gurinder-raju/workbench/README.md

# workbench

Build and make projects — CAD models, prototypes, and iteration notes.

| Project | Description |
|---|---|
| [watch-case](watch-case/) | Pebble-shaped watch case with a hidden 12-to-6 strap tunnel (STL prototypes; V8 adds parametric CAD and STEP; V9 adds water-resistance seals) |
