gurinder-raju/workbench/watch-case/GH_watch_case_V9_pebble42/GH_watch_case_V9_pebble42_assembly_preview.stl

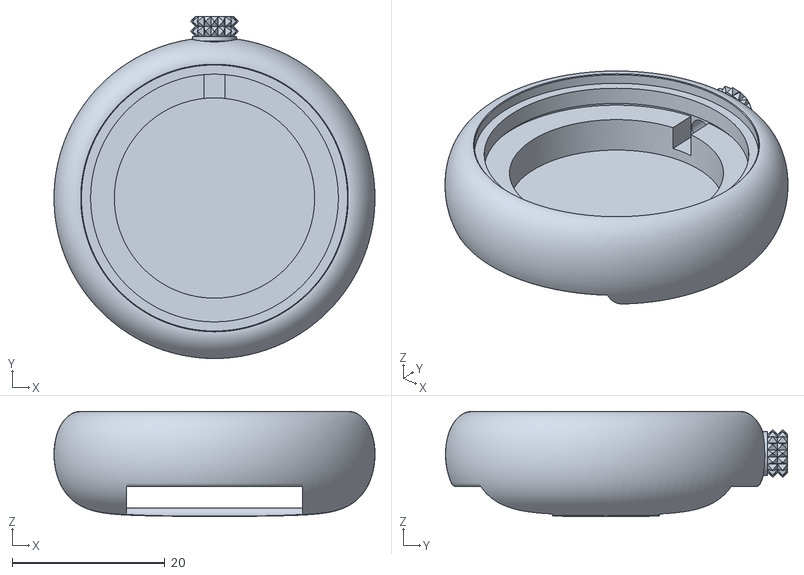
[picture p2: CAD file, 2026-10-15]
watch-case/GH_watch_case_V9_pebble42/GH_watch_case_V9_pebble42_assembly_preview.stl
42.0 x 44.7 x 13.8
