gurinder-raju/workbench/watch-case/step/GH_watch_case_V9_pebble42_assembly.step

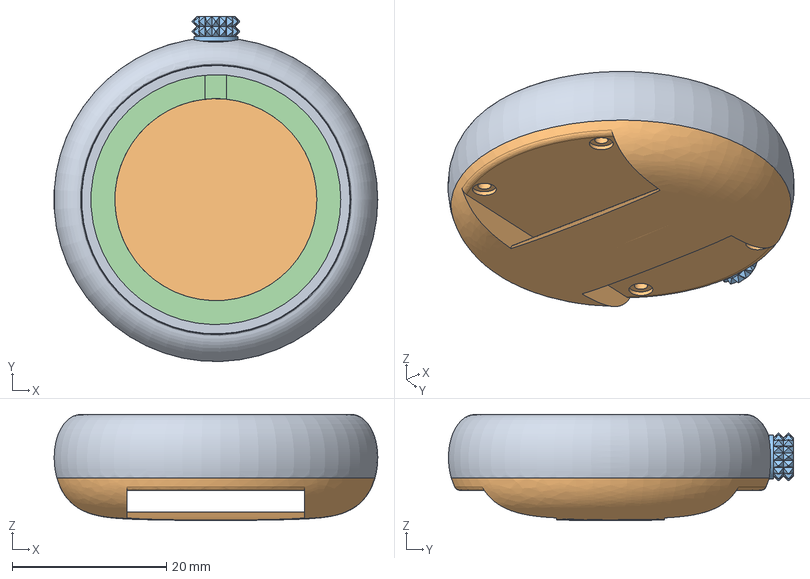
[picture p3: CAD file, 2026-10-15]
watch-case/step/GH_watch_case_V9_pebble42_assembly.step
42.0 x 44.7 x 13.8 mm
