gurinder-raju/workbench/watch-case/GH_watch_case_V7_symmetric_pebble_roundover.stl

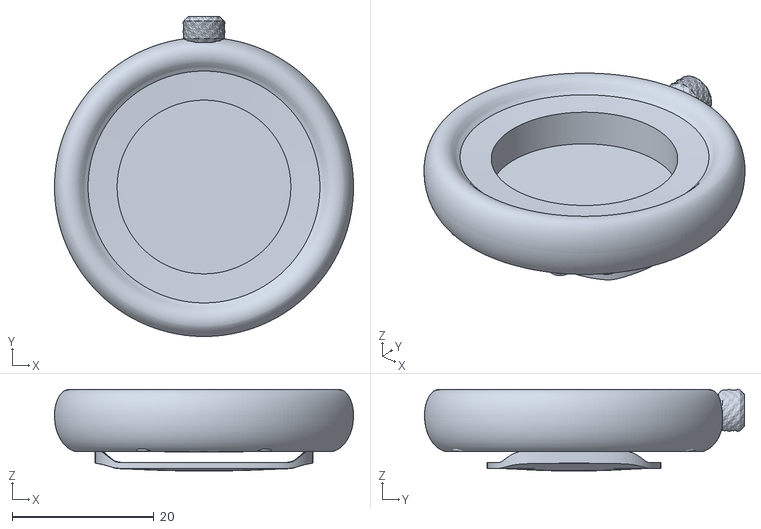
[picture p4: CAD file, 2026-10-13]
watch-case/GH_watch_case_V7_symmetric_pebble_roundover.stl
42.2 x 45.1 x 11.5
