gurinder-raju/workbench/watch-case/GH_watch_case_V9_pebble42/GH_watch_case_V9_pebble42_caseback_bridge.stl

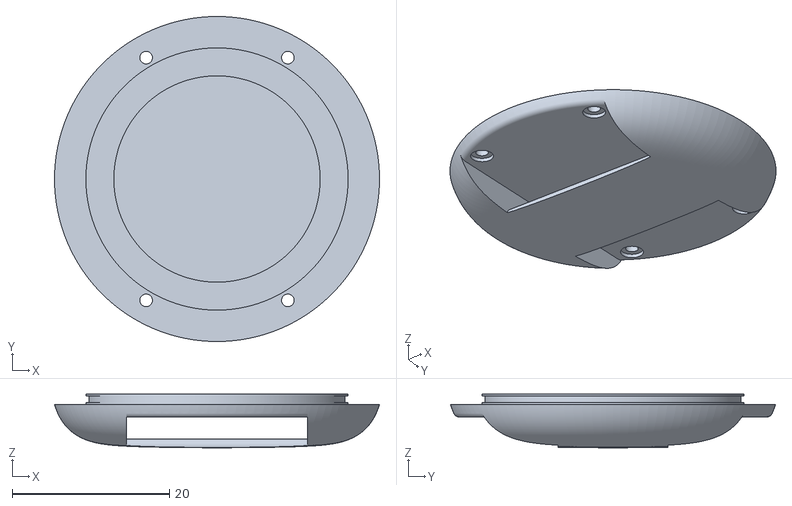
[picture p5: CAD file, 2026-10-15]
watch-case/GH_watch_case_V9_pebble42/GH_watch_case_V9_pebble42_caseback_bridge.stl
41.3 x 41.3 x 6.80
