gurinder-raju/workbench/watch-case/step/GH_watch_case_V9_pebble42_crown.step

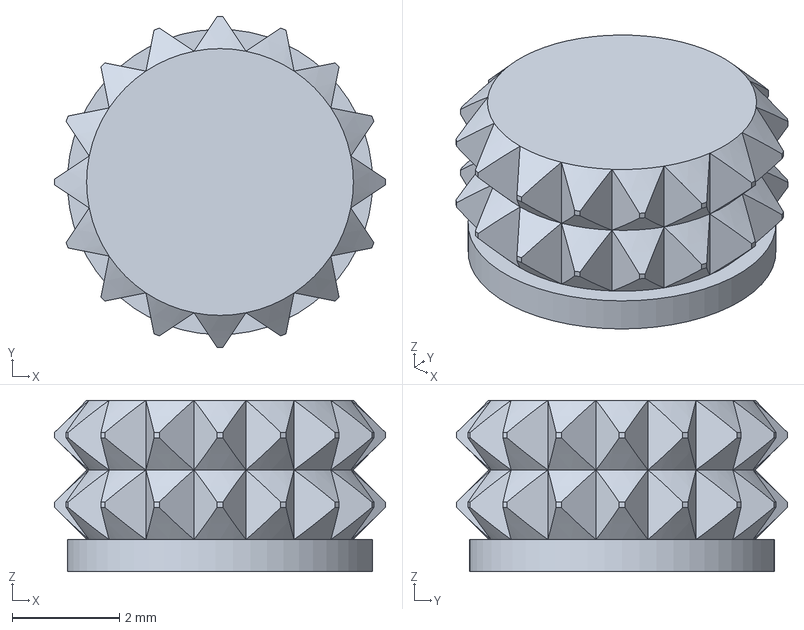
[picture p6: CAD file, 2026-10-15]
watch-case/step/GH_watch_case_V9_pebble42_crown.step
6.18 x 6.18 x 3.20 mm
