gurinder-raju/workbench/watch-case/GH_watch_case_V4_enclosed_pebble_case.stl

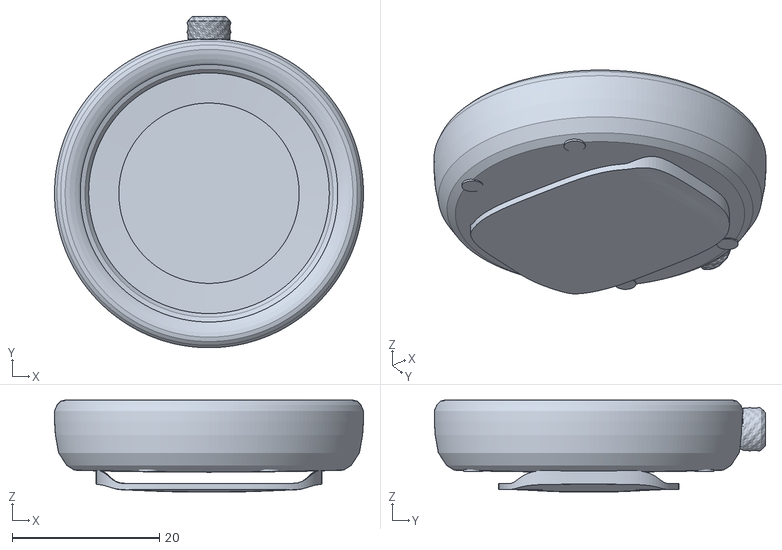
[picture p7: CAD file, 2026-10-13]
watch-case/GH_watch_case_V4_enclosed_pebble_case.stl
42.0 x 45.0 x 12.5
