gurinder-raju/workbench/watch-case/step/GH_watch_case_V9_pebble42_movement_ring.step

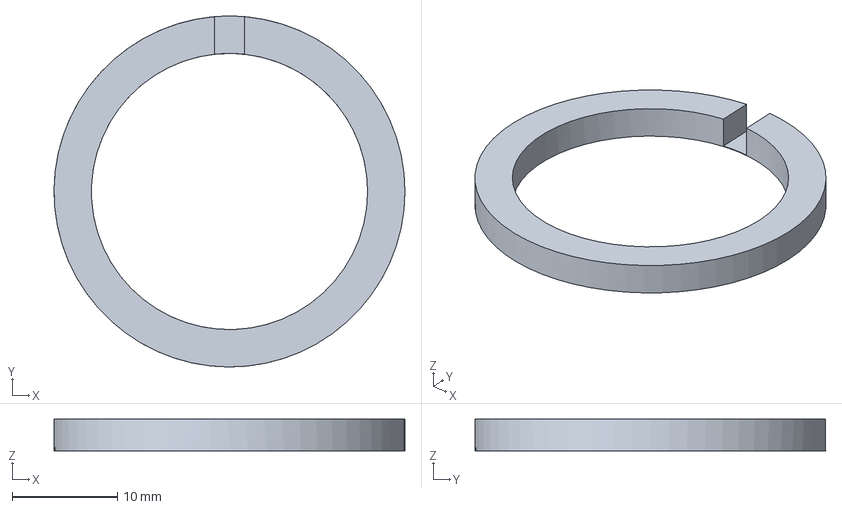
[picture p8: CAD file, 2026-10-15]
watch-case/step/GH_watch_case_V9_pebble42_movement_ring.step
33.3 x 33.3 x 3.00 mm
