gurinder-raju/workbench/watch-case/GH_watch_case_V3_comfort_back_hidden_tunnel.stl

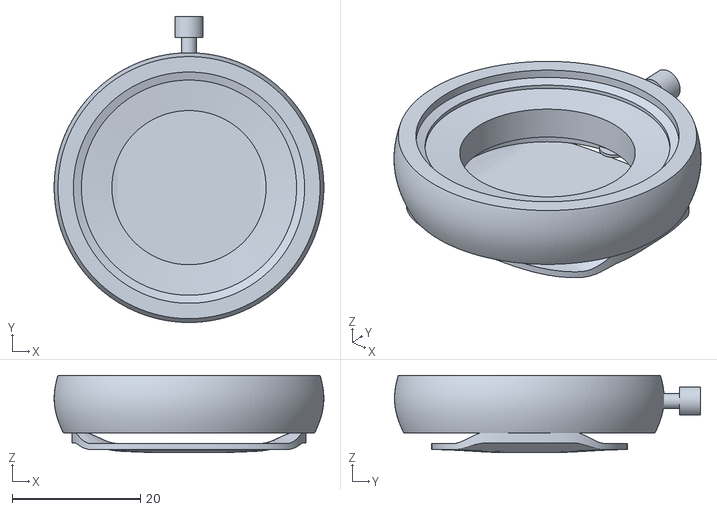
[picture p9: CAD file, 2026-10-11]
watch-case/GH_watch_case_V3_comfort_back_hidden_tunnel.stl
42.0 x 47.7 x 12.1
