gurinder-raju/workbench/watch-case/GH_watch_case_V1_attached_hidden_tunnel.stl

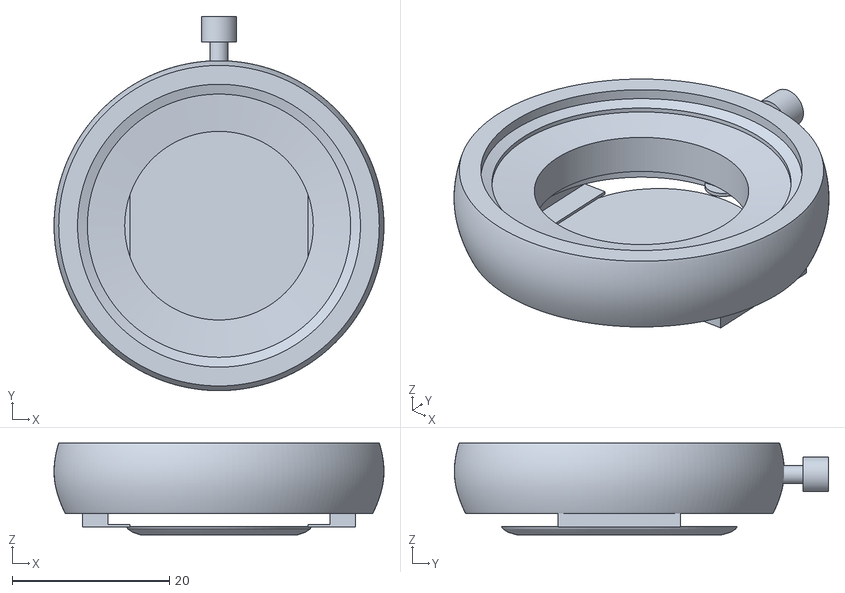
[picture p10: CAD file, 2026-10-11]
watch-case/GH_watch_case_V1_attached_hidden_tunnel.stl
42.0 x 47.7 x 11.7
