gurinder-raju/workbench/watch-case/GH_watch_case_V9_pebble42/GH_watch_case_V9_pebble42_case_body.stl

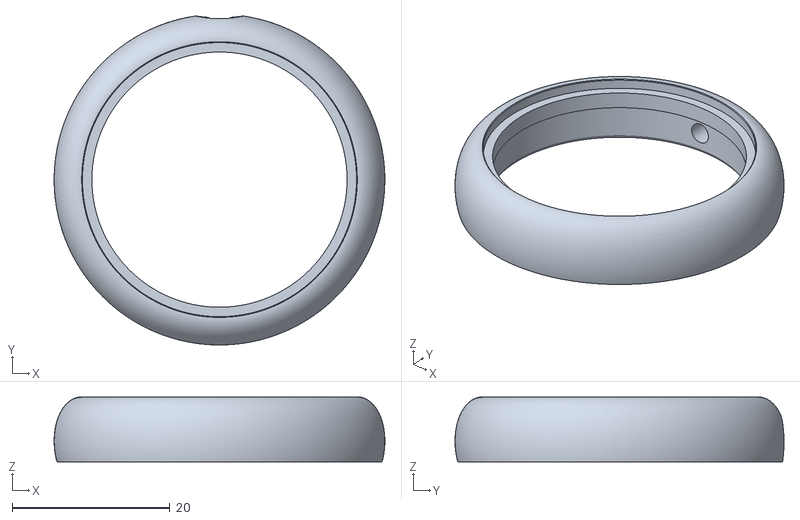
[picture p11: CAD file, 2026-10-15]
watch-case/GH_watch_case_V9_pebble42/GH_watch_case_V9_pebble42_case_body.stl
42.0 x 41.8 x 8.25
