gurinder-raju/workbench/watch-case/GH_watch_case_V8_pebble42/GH_watch_case_V8_pebble42_assembly_preview.stl

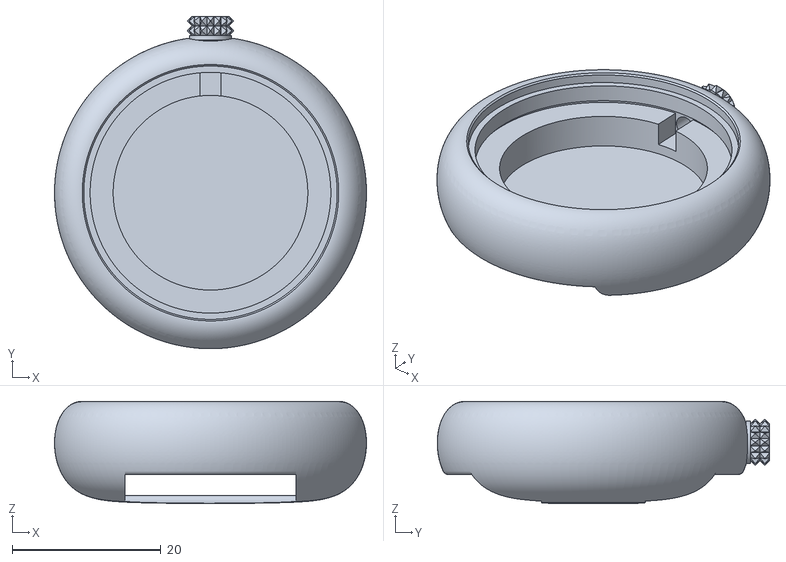
[picture p12: CAD file, 2026-10-14, an earlier design]
watch-case/GH_watch_case_V8_pebble42/GH_watch_case_V8_pebble42_assembly_preview.stl
42.0 x 44.7 x 13.8
