gurinder-raju/workbench/watch-case/GH_watch_case_V8_pebble42/GH_watch_case_V8_pebble42_caseback_bridge.stl

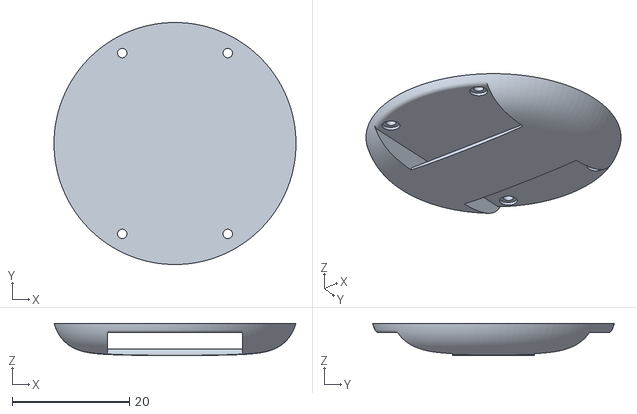
[picture p13: CAD file, 2026-10-14, an earlier design]
watch-case/GH_watch_case_V8_pebble42/GH_watch_case_V8_pebble42_caseback_bridge.stl
41.3 x 41.3 x 5.50
