gurinder-raju/workbench/(list of files, cad)

Other CAD files:
watch-case/GH_watch_case_V9_pebble42/GH_watch_case_V9_pebble42_movement_ring.stl
watch-case/step/GH_watch_case_V9_pebble42_caseback_bridge.step
watch-case/GH_watch_case_V2_refined_hidden_tunnel.stl
watch-case/GH_watch_case_V9_pebble42/GH_watch_case_V9_pebble42_crown.stl
watch-case/step/GH_watch_case_V9_pebble42_case_body.step
watch-case/step/GH_watch_case_V8_pebble42_assembly.step
watch-case/GH_watch_case_V8_pebble42/GH_watch_case_V8_pebble42_case_body.stl
watch-case/GH_watch_case_V8_pebble42/GH_watch_case_V8_pebble42_crown.stl
watch-case/GH_watch_case_V8_pebble42/GH_watch_case_V8_pebble42_movement_ring.stl
watch-case/step/GH_watch_case_V8_pebble42_case_body.step
watch-case/step/GH_watch_case_V8_pebble42_caseback_bridge.step
watch-case/step/GH_watch_case_V8_pebble42_crown.step
watch-case/step/GH_watch_case_V8_pebble42_movement_ring.step
