gurinder-raju/workbench/(commit log)

2026-10-11 Add watch case V1 with attached hidden strap tunnel
    Adds a complete watch case prototype body with the rear strap bridge included in the STL.
    This version establishes the hidden under-case strap-tunnel concept. The bridge attaches at the 3 o'clock and 9 o'clock sides, outside the 22 mm strap lane, so the strap can run from 12 o'clock to 6 o'clock while the visible top remains a smooth pebble-shaped case.
    Key characteristics:
    - 42.0 mm main case width
    - 36.0 mm crystal opening
    - 33.5 mm visible dial reference
    - Crown at 12 o'clock
    - Attached hidden underside strap bridge
    - Side-cheek attachment geometry at 3 and 9 o'clock
    This is a visual/proportion prototype STL, not production-ready CNC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
    [GH_watch_case_V1_attached_hidden_tunnel.stl]
2026-10-11 Refine watch case V2 with smooth hidden tunnel shoulders
    Replaces the more rectangular rear bridge attachment with a smoother hidden underside saddle.
    This version keeps the 22 mm 12-to-6 strap path while improving the transition from the bridge into the underside of the case. The 3 o'clock and 9 o'clock attachments are modeled as continuous curved shoulders rather than box-like structural cheeks.
    Key changes from V1:
    - Smoother underside bridge shape
    - Curved 3/9 o'clock shoulders
    - Better hidden-tunnel design intent
    - Case and attached bridge provided as one complete STL body for prototype review
    This is design-intent mesh geometry for resin prototyping. A production CNC version should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
    [GH_watch_case_V2_refined_hidden_tunnel.stl]
2026-10-11 Add watch case V3 comfort-back underside contour
    Adds the current best version of the watch case prototype with a comfort-contoured underside.
    This revision keeps the refined hidden strap tunnel and smooth 3/9 o'clock bridge shoulders, while reshaping the wrist-facing back so the center is the deepest point and the underside gradually lifts toward the perimeter. This better reflects how a wearable watch case should sit on the wrist and reduces abrupt pressure points.
    Key changes from V2:
    - Comfort-contoured wrist-facing underside
    - Center underside sits lowest, with gradual lift toward edges
    - Smooth attached hidden saddle retained
    - 22 mm 12-to-6 strap path retained
    - Complete case-plus-b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
    [GH_watch_case_V3_comfort_back_hidden_tunnel.stl]
2026-10-13 Add watch case V4 with enclosed back and rounded pebble top
    Adds a revised complete watch case prototype STL based on physical print feedback.
    This version improves the case architecture, strap handling, and visual proportions. The rear of the watch is now enclosed before the strap bridge, so the strap path is separated from the internal watch cavity. The underside bridge remains shortened in the 12-to-6 direction to leave future fastening zones, while the usable strap lane is relaxed to approximately 24.0 mm so a 22 mm strap has enough room to be threaded and adjusted without excessive side-to-side looseness.
    Key changes from V3:
    - Adds an enclosed rear caseback behind the movement cavity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
    [GH_watch_case_V4_enclosed_pebble_case.stl]
2026-10-13 Add watch case V7 with symmetric pebble roundover
    Adds a follow-up surface refinement to make the upper case curvature match the lower pebble-like roundover more closely.
    This version keeps the enclosed back, hidden strap bridge, approximately 24.0 mm strap lane, enlarged crown, and future screw-land layout. The main change is the outer case cross-section: the upper side now starts tapering inward earlier, with a larger-radius top roundover instead of a mostly vertical side wall ending in a small top corner.
    [GH_watch_case_V7_symmetric_pebble_roundover.stl]
2026-10-13 Add watch case V8: parametric 42 mm pebble with crown at 12 and short strap bridge
    Rebuilds the case from scratch as a parametric CAD model (build123d) instead of a hand-made mesh.
    - One continuous, curvature-smooth pebble profile (no kinks in polished reflections)
    - Bezel inner edge 34.7 mm, visible dial 32.4 mm
    - 42.00 mm wide, 13.75 mm total, thickness/diameter 0.327
    - Stack built around a Miyota 9039: 0.4 rotor clearance, 1.75 hand stack + 0.4, 34.0 x 1.2 flat crystal
    - Crown at 12: clous de Paris, 2 rows x 16 pyramids, collar tucked into a counterbore
    - 22 mm strap through a 23.0 x 2.8 mm tunnel; bridge only 14 mm long so the strap drapes
    - 4 x standard M1.4 x 4 caseback screws, 2 at 1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
    [GH_watch_case_V8_pebble42_assembly.step, GH_watch_case_V8_pebble42_assembly_preview.stl, GH_watch_case_V8_pebble42_case_body.step, GH_watch_case_V8_pebble42_case_body.stl, GH_watch_case_V8_pebble42_caseback_bridge.step, GH_watch_case_V8_pebble42_caseback_bridge.stl, GH_watch_case_V8_pebble42_crown.step, GH_watch_case_V8_pebble42_crown.stl]
2026-10-14 Make V8 caseback screw seats flush for M1.4 wafer-head screws
    Sizes the four caseback screw seats for the M1.4 x 4 flat round (wafer) head screws chosen for the build (head 2.5 x 0.5 mm, 0.3 mm pitch).
    - Head seat 2.9 mm wide, now 0.5 mm deep: the head sits flush with the strap tunnel ceiling
    - Caseback plate under each head doubles from 0.6 to 1.1 mm
    - Pilot holes 0.5 mm shallower to match; each screw grips 2.9 mm into the case
    - Fit check updated for the wafer-head screw: no collisions, thinnest wall 0.46 mm
    [GH_watch_case_V8_pebble42_assembly.step, GH_watch_case_V8_pebble42_assembly_preview.stl, GH_watch_case_V8_pebble42_case_body.step, GH_watch_case_V8_pebble42_case_body.stl, GH_watch_case_V8_pebble42_caseback_bridge.step, GH_watch_case_V8_pebble42_caseback_bridge.stl, GH_watch_case_V8_pebble42_crown.step, GH_watch_case_V8_pebble42_movement_ring.step]
2026-10-15 Add watch case V9: sealed for water resistance (crystal gasket, caseback O-ring, crown O-ring)
    Moves the case from a display prototype toward a wearable, water-resistant watch.
    Each of the three ways water gets in now has a standard watch seal, sized to
    off-the-shelf gaskets, so this last print tests the same sealing geometry that goes to CNC.
    Target: about 3 ATM (rain, hand-washing, splashes) with the crown pushed in.
    Crystal
    - Seat 34.80 for a 34.0 x 1.2 crystal in a Hytrel I-ring gasket (0.45 wall x 0.90 high), 0.05 squeeze per side
    - Pressed in by a watchmaker with a crystal press, so it can be serviced (no glue)
    - Bezel crest moved out to 35.2 mm (0.838 x D) so the seat doesn't leave a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
    [GH_watch_case_V9_pebble42_assembly.step, GH_watch_case_V9_pebble42_assembly_preview.stl, GH_watch_case_V9_pebble42_case_body.step, GH_watch_case_V9_pebble42_case_body.stl, GH_watch_case_V9_pebble42_caseback_bridge.step, GH_watch_case_V9_pebble42_caseback_bridge.stl, GH_watch_case_V9_pebble42_crown.step, GH_watch_case_V9_pebble42_crown.stl]
